OpBox/OpBox_Master/README.md

# OpBox_Master
All Code and Supplementary info for OpBox system

Arduino: Code and libraries to run behavioral task code using Arduino boards

How To: Step-by-step instructions on how to build and implement different components of our system

MATLAB: MATLAB code including scripts for data acquisition and loading recorded data

Processing: Code and libraries for acquiring video and real-time monitoring of Arduino-based behavioral tasks
