OpBox/OpBox_Master/MATLAB/README.md

# OpBoxMAT
MATLAB code for recording physiology data using National Instruments data acquisition devices, plus loading synchronized physiology and behavioral data.
