OpBox/OpBox_Master/HowTo/OpBoxPartsList.xls

Sheet: OpBox
Ordering frequency | SystemPart | Equipment | Vendor | Cost | # | Total | VendorPart | MfgPart | Manufacturer | Web | Notes | Notes | Cost per OpBox | $1409.70 | Possible 1 time expenses | $2499.94
For 10 External Boxes | External Box | Handle | 3D part |  | 10 |  | Custom
For 10 External Boxes | External Box | Contact paper | Amazon
For 10 External Boxes | External Box | Wood: CDX Fir | Jackson Lumber | 65.2400 | 10 | $652.40 |  |  |  |  | 6 precut pieces of CDX Fir: External dimensions for Animal facility rack
For 10 External Boxes | External Box | Hinge Screws: Screw for Wood Phillips, Brass, Number 3, 1/2" Long (Pack of 100) | McMaster | 4.5000 | 1 | $4.50 | 92114A096 |  |  | http://www.mcmaster.com/#92114a096/=ujr445 | #3 Wood Screws For Piano Hinge for boxes
For 10 External Boxes | External Box | Hinge: Type 304 Stainless Steel Piano Hinge with Holes: Unfinished, .025" Thickness, 3/4" Width (1 Ft) | McMaster | 8.6500 | 10 | $86.50 | 97946A100 |  |  | http://www.mcmaster.com/#97946a100/=ujfcyg | For 3/8" Wood box
For 10 External Boxes | External Box | Latch: Velcro | McMaster |  | 1
For 10 External Boxes | External Box | Sound Foam | McMaster |  | 10
For 10 OpBoxes | Behavior: Arduino | CBL USB A-B CON 6' 26/28 AWG | DigiKey | 2.5200 | 10 | $25.20 | Q364-ND | 3021007-06 | Qualtek | http://www.digikey.com/product-detail/en/3021007-06/Q364-ND/1531291 | USB A-to-B cable for Arduino
For 10 OpBoxes | Behavior: Arduino | Power Supply AC/DC WALL MOUNT ADAPTER 12V 36W | DigiKey | 20.2700 | 2 | $40.54 | 237-1443-ND | WSU120-3000 | Triad Magnetics | http://www.digikey.com/product-detail/en/WSU120-3000/237-1443-ND/3094969 | Power supply to be shared among multiple Arduinos | 1
For 10 OpBoxes | Behavior: Arduino | 1x8 DC Power Splitter | M C M Electronics | 6.4900 | 2 | $12.98 | 82-16592 | CT-1S8 | Defender Security | http://www.mcmelectronics.com/product/82-16592 | DC Power splitter to supply each Arduino | 1
For 10 OpBoxes | Behavior: Arduino | ARDUINO A000067 DEV BRD, ATMEGA2560, ARDUINO MEGA 2560 R3 | Newark | 40.4300 | 10 | $404.30 | 45W6205 | A000067 | Arduino | http://www.newark.com/arduino/a000067/dev-brd-atmega2560-arduino-mega/dp/45W6205?ost=A000067 | Arduino Mega 2560
For 10 OpBoxes | Behavior: Arduino | Rosewill RHB-500 - Hub - 10 x Hi-Speed USB - desktop | TigerDirect | 26.9900 | 1 | $26.99 | RWI-102665969 | 11380473 | Rosewill | http://www.tigerdirect.com/applications/SearchTools/item-details.asp?EdpNo=9264070&CatId=11652 | USB Hub
For 10 OpBoxes | Behavior: Fluid | Peristaltic Liquid Pump with Silicone Tubing | M C M Electronics | 23.9900 | 10 | $239.90 | 28-17461 | 1150 | Adafruit | http://www.mcmelectronics.com/product/28-17461 | Peristaltic Pumps, come with 2 pieces of silicone tubing, only need to keep 1 per box | 1
For 10 OpBoxes | Behavior: Fluid | 50 ml amber conical tubes, polypropylene, trays, sterile (Pack of 25) | USA Scientific | 14.5000 | 1 | $14.50 | 5622-7283P |  |  | http://www.usascientific.com/5622-7283p50mlamberconicaltubespolypropylenetrayssterile.aspx | 50ml "Falcon" tube Fluid resevoir
For 10 OpBoxes | Behavior: Fluid | Food and Beverage Nylon Barbed Tube Fitting: Reducing Straight for 1/8" x 1/16" Tube ID (Pack of 10) | McMaster | 2.7600 | 1 | $2.76 | 5116K21 |  |  | http://www.mcmaster.com/#5116k21/=pmsvl0 | Adapter from pump tubing to line tubing
For 10 OpBoxes | Behavior: Fluid | Food and Dairy Clear Tygon PVC Tubing: 1/16" ID, 1/8" OD, 1/32" Wall Thickness | McMaster | 0.2500 | 60 | $15.00 | 6546T33 |  |  | http://www.mcmaster.com/#6546t33/=pmfu94 | Tubing to spout from pump adapter to spout, depends on pump placement (anywhere from 3'-10' depending on the room arrangement)
For 10 OpBoxes | Behavior: Fluid | Masterkleer PVC Tubing (Tygon): 1/8" ID, 1/4" OD | McMaster | 0.1200 | 2 | $0.24 | 5233K52 |  |  | http://www.mcmaster.com/#5233k52/=ocnpnt | Tubing to stabilize narrow tubing within spout, need 2" per spout
For 10 OpBoxes | Behavior: Nosepoke | LED IR 5MM GAA1AS BLUE TH | DigiKey | 0.3150 | 20 | $6.30 | 1080-1080-ND | IR333-A | Everlight Electronics | http://www.digikey.com/product-detail/en/IR333-A/1080-1080-ND/2675571 | Nosepoke IR LED emitters
For 10 OpBoxes | Behavior: Nosepoke | PHOTOTRANSISTOR 5MM BLACK RAD | DigiKey | 0.2700 | 20 | $5.40 | 1080-1158-ND | PT334-6B | Everlight Electronics | http://www.digikey.com/product-detail/en/PT334-6B/1080-1158-ND/2675649 | Nosepoke IR phototransistors
For 10 OpBoxes | Behavior: Nosepoke & Operant Device Connections | FEMALE CRIMP CONTACT SELECTIVE | DigiKey | 0.0840 | 60 | $5.04 | 952-2158-ND | M20-1180042 | Harwin | http://www.digikey.com/product-detail/en/M20-1180042/952-2158-ND/3728124 | M20 Harwin female crimp contacts (22-30 AWG)
For 10 OpBoxes | Behavior: Nosepoke & Operant Device Connections | SIL FEMALE CRIMP HOUSING 2POS | DigiKey | 0.1220 | 30 | $3.66 | 952-2227-ND | M20-1060200 | Harwin | http://www.digikey.com/product-detail/en/M20-1060200/952-2227-ND/3728191 | M20 Harwin female crimp housing
For 10 OpBoxes | Behavior: Nosepoke & Operant Device Connections | HEATSHRNK POLY 1/16" BLK 4' 3:1 | Digi-Key | 0.4240 | 5 | $2.12 | Q2F3X116B-ND | Q2-F3X-1/16-01-QB48IN-25 | Qualtek | http://www.Digi-Key.com/product-detail/en/Q2-F3X-1%2F16-01-QB48IN-25/Q2F3X116B-ND/1210315 (http://www.digikey.com/product-detail/en/Q2-F3X-1%2F16-01-QB48IN-25/Q2F3X116B-ND/1210315) | Heat Shrink tubing:
For 10 OpBoxes | Behavior: Nosepoke & Operant Device Connections | Hook-up Wire 24AWG 7/32 PVC 100ft SPOOL BLACK | Mouser | 22.5100 | 1 | $22.51 | 602-3050-100-02 | 3050 BK005 | Alpha Wire | http://www.mouser.com/ProductDetail/Alpha-Wire/3050-BK005/?qs=sGAEpiMZZMtW9UaYX5J1tM4kpfBO860LCrBFdBMIySg%3d | Hook up wire for operant devices
For 10 OpBoxes | Behavior: Nosepoke & Operant Device Connections | Hook-up Wire 24AWG 7/32 PVC 100ft SPOOL RED | Mouser | 22.5100 | 1 | $22.51 | 602-3050-100-03 | 3050 RD005 | Alpha Wire | http://www.mouser.com/ProductDetail/Alpha-Wire/3050-RD005/ | Hook up wire for operant devices
For 10 OpBoxes | Behavior: Nosepoke: LED | LED SS 5MM 568NM GREEN DIFF | DigiKey | 0.1040 | 10 | $1.04 | 754-1263-ND | WP7113GD | Kingbright | http://www.digikey.com/product-detail/en/WP7113GD/754-1263-ND/1747662 | Nosepoke Green Visible LED
For 10 OpBoxes | Behavior: Nosepoke: Spout | Open Drinking Tube: Straight 2” Length | Ancare | 1.0900 | 10 | $10.90 | OT-99.5 | OT-99.5 | Ancare | http://www.ancare.com/products/watering-equipment/open-drinking-tubes/straight-tubes-open-tip | Nosepoke Spout
For 10 OpBoxes | Behavior: Nosepoke: Spout | Combination Drive Screws for Sheet Metal: #4, 1/2" (pack of 100) | McMaster | 5.1800 | 1 | $5.18 | 92465A142 |  |  | http://www.mcmaster.com/#92465a142/=oz8hit | Drive screws to secure spout
For 10 OpBoxes | Behavior: OpBoxShield | CAP CER 0.068UF 50V 10% RADIAL | DigiKey | 0.2000 | 10 | $2.00 | 445-5302-ND | FK18X7R1H683K | TDK Corporation | http://www.digikey.com/product-detail/en/FK18X7R1H683K/445-5302-ND/2256782 | Capacitor for Audio HPF, 68nF cutoff w/1k Ohm = 2.3405 kHz
For 10 OpBoxes | Behavior: OpBoxShield | CAP CER 6800PF 50V 10% RADIAL | DigiKey | 0.2040 | 10 | $2.04 | 445-5296-ND | FK18X7R1H682K | TDK Corporation | http://www.digikey.com/product-detail/en/FK18X7R1H682K/445-5296-ND/2256776 | Capacitor for Audio LPF, 6.8nF cutoff w/1k Ohm = 23.405 kHz
For 10 OpBoxes | Behavior: OpBoxShield | CAP ALUM 10UF 25V 10% RADIAL | DigiKey | 0.2870 | 20 | $5.74 | 493-13398-ND | UKL1E100KDDANA | Nichicon | http://www.digikey.com/product-detail/en/UKL1E100KDDANA/493-13398-ND/2598410 | Capacitor for Power at Battery outputs
For 10 OpBoxes | Behavior: OpBoxShield | IDC BOX HEADER .100" 20POS | DigiKey | 0.6300 | 10 | $6.30 | 1175-1612-ND | 3020-20-0100-00 | CNC Tech | http://www.digikey.com/product-detail/en/3020-20-0100-00/1175-1612-ND/3441738 | Board connector for device ribbon cable
For 10 OpBoxes | Behavior: OpBoxShield | PHOTOCOUPLER PHOTORELAY 4-DIP | DigiKey | 1.0130 | 10 | $10.13 | TLP222AF-ND | TLP222A(F) | Toshiba | http://www.digikey.com/product-detail/en/TLP222A(F)/TLP222AF-ND/871243 | Solid state relay (<= 2ms on/off)
For 10 OpBoxes | Behavior: OpBoxShield | RES 100 OHM 1W 5% AXIAL | DigiKey | 0.0940 | 40 | $3.76 | 100WCT-ND | FMP100JR-52-100R | Yageo | http://www.digikey.com/product-detail/en/FMP100JR-52-100R/100WCT-ND/2058886 | Small resistors for OperantShield
For 10 OpBoxes | Behavior: OpBoxShield | RES 120 OHM 1/2W 5% AXIAL | DigiKey | 0.1320 | 20 | $2.64 | 120DVCT-ND | FRM50SJR-52-120R | Yageo | http://www.digikey.com/product-detail/en/FRM50SJR-52-120R/120DVCT-ND/2813214 | Small 1/2 Watt resistors for OperantShield
For 10 OpBoxes | Behavior: OpBoxShield | RES 1K OHM 1W 5% AXIAL | DigiKey | 0.0940 | 40 | $3.76 | 1KWCT-ND | FMP100JR-52-1K | Yageo | http://www.digikey.com/product-detail/en/FMP100JR-52-1K/1KWCT-ND/2058902 | Small 1 Watt. Thin resistors for tight OperantShield spacing
For 10 OpBoxes | Behavior: OpBoxShield | RES 2K OHM 1/4W 1% AXIAL | DigiKey | 0.0840 | 10 | $0.84 | 2.00KXBK-ND | MFR-25FBF52-2K | Yageo | http://www.digikey.com/product-detail/en/MFR-25FBF52-2K/2.00KXBK-ND/13070 | Small resistors for relay on OperantShield
For 10 OpBoxes | Behavior: OpBoxShield | RES 330 OHM 1W 5% AXIAL | DigiKey | 0.0940 | 30 | $2.82 | 330WCT-ND | FMP100JR-52-330R | Yageo | http://www.digikey.com/product-detail/en/FMP100JR-52-330R/330WCT-ND/2058918 | Small 1 Watt resistors for OperantShield
For 10 OpBoxes | Behavior: OpBoxShield | CONN BNC JACK R/A 50 OHM PCB | DigiKey | 1.8380 | 10 | $18.38 | A97553-ND | 1-1337543-0 | TE Connectivity | http://www.digikey.com/product-detail/en/1-1337543-0/A97553-ND/1755940 | BNC output jack for digital triggers
For 10 OpBoxes | Behavior: OpBoxShield | IC MOTOR DRIVER PAR 16-DIP | DigiKey | 3.7500 | 10 | $37.50 | 296-9518-5-ND | L293DNE | Texas Instruments | http://www.digikey.com/product-detail/en/L293DNE/296-9518-5-ND/379724 | Pump motor driver (reversible for 2 pumps)
For 10 OpBoxes | Behavior: OpBoxShield | CONN HEADER VERT .100 2POS 30AU | Digi-Key | 0.5650 | 100 | $56.50 | A28473-ND | 103908-1 | TE Connectivity | http://www.digikey.com/product-detail/en/103908-1/A28473-ND/298654 | AmpModu 2 pin male housing for board, with Latch. Press-Fit, Solder. For connections of each 2 conductor cable, extra stability
For 10 OpBoxes | Behavior: OpBoxShield | CONN HEADER VERT 2POS .100 TIN | Digi-Key | 0.0804 | 100 | $8.04 | A1921-ND | 640456-2 | TE Connectivity | http://www.digikey.com/product-detail/en/640456-2/A1921-ND/109003 | Alternative Friction lock rather than latch lock for 2 conductor cables. Match with MTA100 connectors, allow for tighter spacing than latch lock
For 10 OpBoxes | Behavior: OpBoxShield | CONN TERMINAL BLOCK 2POS 3.5MM | Digi-Key | 0.6550 | 10 | $6.55 | WM7877-ND | 0393570002 | Molex Inc | http://www.digikey.com/product-detail/en/0393570002/WM7877-ND/946543 | Terminal Screw Block: For operant shield multiplexed digital->analog output | ?
For 10 OpBoxes | Behavior: OpBoxShield | CONN TERMINAL BLOCK 6POS 5.08MM | Digi-Key | 2.0420 | 10 | $20.42 | WM7857-ND | 0395443006 | Molex Inc | http://www.digikey.com/product-search/en?x=0&y=0&lang=en&site=us&keywords=WM7857-ND | Terminal Screw Block: 6 position for 5 signal & 1 Ground digital outputs | ?
For 10 OpBoxes | Behavior: OpBoxShield | RES NET MULT OHM 16 RES 10SIP | Digi-Key | 0.9300 | 10 | $9.30 | 4310R-R2R-103LF-ND | 4310R-R2R-103LF |  | http://www.digikey.com/product-detail/en/4310R-R2R-103LF/4310R-R2R-103LF-ND/3741102 | R2R Resistor Ladder Network for DAC Arduino->NI USB | ?
For 10 OpBoxes | Behavior: OpBoxShield | Male pins HEADER, 2.54MM, THT VERT, 36POS | Newark | 2.8100 | 10 | $28.10 | 02R1933 | TSW-118-10-F-D | Samtec Inc | http://www.newark.com/samtec/tsw-118-10-f-d/header-2-54mm-tht-vert-36pos/dp/02R1933 | Male pins for PosTrack connections. Could also do 10 pin stackable headers side by side with male pin interface | ?
For 10 OpBoxes | Behavior: OpBoxShield | Arduino 8-Pin Stackable Headers (10) | RobotShop | 2.9900 | 4 | $11.96 | RB-Dfr-269 |  |  | http://www.robotshop.com/en/arduino-8-pin-stackable-headers-10.html | Arduino headers, 10 per pack, need 4 per board (if not using analog inputs, and if using male pins at PosTrack side--otherwise would need 10) | ?
For 10 OpBoxes | Behavior: OpBoxShield | OperantShield Printed Circuit Board | Sunstone | 27.7000 | 10 | $277.00 | Custom | OperantShield | DeliriumLab.org | http://deliriumlab.org/ | Custom PCB for Operant Shield
For 10 OpBoxes | Behavior: Operant Device Connections | CABLE 40 COND 50FT FLAT GRAY | DigiKey | 50.5000 | 1 | $50.50 | MC40G-50-ND | 3365/40 300SF | 3M | http://www.digikey.com/product-detail/en/3365%2F40%20300SF/MC40G-50-ND/145467 | Ribbon cable for operant devices: ten 10' cables (1/2 of full width). Approximately twice as much for multicolor | 1
For 10 OpBoxes | Behavior: Operant Device Connections | CONN SOCKET IDC 20POS W/KEY GOLD | DigiKey | 0.4130 | 20 | $8.26 | ED10503-ND | 101-206 | On Shore Technology Inc | http://www.digikey.com/product-detail/en/101-206/ED10503-ND/2794215 | IDC press connector for Ribbon cable to devices, does not get soldered onto shield itself | 1
For 10 OpBoxes | Behavior: Operant Device Connections | Symmetric Male Pins: CONN HEADER .100" SNGL STR 40POS | DigiKey | 0.6400 | 5 | $3.20 | S1022EC-40-ND | PREC040SABN-RC | Sullins | http://www.digikey.com/product-detail/en/PREC040SABN-RC/S1022EC-40-ND/2775014 | Male 5.84mm pins. 20 pins per box = 200pins. For Device cable
For 10 OpBoxes | Behavior: PosTrack | CBL RIBN 34COND 0.050 GRAY 100' | DigiKey | 77.2700 | 1 | $77.27 | MC34G-100-ND | 3365/34 300SF | 3M | http://www.digikey.com/product-detail/en/3365%2F40%20300SF/MC40G-50-ND/145467 | Ribbon cable for PosTrack: ten 10' cables (full width). Approximately twice as much for multicolor
For 10 OpBoxes | Behavior: PosTrack | CONN SOCKET IDC 34POS W/KEY GOLD | DigiKey | 0.5610 | 10 | $5.61 | HKC34H-ND | AWP34-7240-T-R |  | http://www.digikey.com/product-detail/en/AWP34-7240-T-R/HKC34H-ND/924351 | Connector to Arduino for Ribbon cable to photodarlingtons
For 10 OpBoxes | Behavior: PosTrack | IR EMITTER 850NM HIGH SPEED DIP | DigiKey | 0.8438 | 210 | $177.20 | VSLY5850-ND | VSLY5850 | Vishay | http://www.digikey.com/product-detail/en/VSLY5850/VSLY5850-ND/2615286 | Narrow IR LED emitters for PosTrack, need 21/box for 9"x12" box
For 10 OpBoxes | Behavior: PosTrack | MTA 100: Headers & Wire Housings FEED THRU W/O TAB 2P green tin 28 AWG | DigiKey | 0.1727 | 200 | $34.54 | A30814-ND | 3-640623-2 | TE Connectivity | http://www.digikey.com/product-search/en?KeyWords=3-640623-2&WT.z_header=search_go | For IR photodarlington connections for PosTrack (need 22 per box: 21 photodarlingtons + ground connection)
For 10 OpBoxes | Behavior: PosTrack | PHOTODARLINGTON SILICON NPN T-1 (OP535B) | DigiKey | 0.7100 | 210 | $149.10 | 365-1604-ND | OP535B | TT Electronics/Optek | http://www.digikey.com/product-detail/en/OP535B/365-1604-ND/1636678 | Sensitive IR photodarlingtons for PosTrack, need 21/box for 9"x12" box
For 10 OpBoxes | Behavior: PosTrack | MTA-100 CONN STRAIN RELIEF COVER 2POS | Digi-Key | 0.2708 | 30 | $8.12 | A19230-ND | 643075-2 | TE Connectivity | http://www.digikey.com/product-detail/en/643075-2/A19230-ND/258866 | Optional Strain relievers: Terminator MTA 100 connectors
For 10 OpBoxes | Behavior: PosTrack | MTA-100 CONN STRAIN RELIEF COVER 2POS | Digi-Key | 0.2533 | 200 | $50.66 | A19270-ND | 643077-2 | TE Connectivity | http://www.digikey.com/product-detail/en/643077-2/A19270-ND/258891 | Optional Strain relievers: Pass through MTA 100 connectors
For 10 OpBoxes | Behavior: PosTrack | Hook-up Wire 28AWG 7/36 PVC 100ft SPOOL BLACK | Mouser | 19.5800 | 1 | $19.58 | 602-3048-100-02 | 3048 BK005 | Alpha Wire | http://www.mouser.com/ProductDetail/Alpha-Wire/3048-BK005/?qs=sGAEpiMZZMtW9UaYX5J1tGDFHZdPhOTYWWT7MJgMuTU%3d | Ground wire for Position Tracker
For 10 OpBoxes | Behavior: PosTrack + Pump | MTA 100: Headers & Wire Housings CLOSED W/O TABS 2P white tin 24 AWG | Mouser | 0.1200 | 30 | $3.60 | 571-640441-2 | 640441-2 | TE Connectivity | http://www.mouser.com/ProductDetail/TE-Connectivity/640441-2/ | For IR LED emitter connections for PosTrack, 3 per 21 LEDs (can run 7 on 12 V)
For 10 OpBoxes | Behavior: Speaker | SPEAKER 8 OHM .1W 40MM ROUND | DigiKey | 3.6240 | 10 | $36.24 | GF0401M-ND | GF0401M | CUI Inc | http://www.digikey.com/product-detail/en/GF0401M/GF0401M-ND/304449 | Relatively flat frequency response speaker | 1
For 10 OpBoxes | Behavior: Webcam | Micro Innovations ChatCam | P C Connection | 11.0900 | 10 | $110.90 | 12556153 | 4310100 | Digital Innovations | http://www.pcconnection.com/product/micro-innovations-chatcam/4310100/12556153?cac=Result | WebCam modifiable for Infrared
For 10 OpBoxes | Physiology: Acquisition from Amplifier | 10' BNC M-M Patch Cable RG58 Coax 50 ohm | M C M Electronics | 3.7700 | 8 | $30.16 | 24-15626 | 24-15626 | Pro Signal | http://www.mcmelectronics.com/product/24-15626 | Connection from Physiology Amplifier to Acquisition
For 10 OpBoxes | Physiology: Acquisition from Amplifier | NI CB-68LPR Unshielded 68-pin I/O Connector Block | National Instruments | 114.0000 | 2 | $228.00 | 777145-02 |  |  | http://sine.ni.com/nips/cds/view/p/lang/en/nid/1186 | Breakout board for NI PCI cards
For 10 OpBoxes | Physiology: Acquisition from Amplifier | NI PCI-6225 16-Bit, 250 kS/s, 80 Analog Inputs Multifunction DAQ | National Instruments | 1348.0000 | 1 | $1348.00 | 779295-01 |  |  | http://sine.ni.com/nips/cds/view/p/lang/en/nid/201605 | Acquisition Card: 40 Differential Analog Inputs, 8 Clocked Digital Inputs
For 10 OpBoxes | Physiology: Acquisition from Amplifier | NI PCIe-6323 X Series Data Acquisition | National Instruments | 869.0000 | 0 | $0.00 | 781045-01 |  |  | http://sine.ni.com/nips/cds/view/p/lang/en/nid/207406 | Acquisition Card: 16 Differential Analog Inputs, 32 Clocked Digital Inputs. If subsitute or add this to PCI-6225, will have to substitute shielded cables since analog & digital are mixed on both boxes and double the overall number of NI parts (16 channels = 5 subjects)
For 10 OpBoxes | Physiology: Acquisition from Amplifier | NI USB-6009 14-Bit, 48 kS/s Low-Cost Multifunction DAQ | National Instruments | 299.0000 | 1 | $299.00 | 779026-01 |  |  | http://sine.ni.com/nips/cds/view/p/lang/en/nid/201987 | Acquisition Device: USB: 4 Differential Analog Inputs, but no clocked Digital Inputs. If use this do not need breakout boards and cables, but will need 10, 1 for each subject. The behavioral data will then need to be multiplexed into the remaining analog channel
For 10 OpBoxes | Physiology: Acquisition from Amplifier | NI SHC68-68 Cable (2m) | National Instruments | 103.0000 | 1 | $103.00 | 191945-02 |  |  | http://sine.ni.com/nips/cds/view/p/lang/en/nid/201629 | No shielding for analog only portion of PCI-6225, Recommended by NI
For 10 OpBoxes | Physiology: Acquisition from Amplifier | NI SHC68-68-EPM Cable (2m) | National Instruments | 140.0000 | 1 | $140.00 | 192061-02 |  |  | http://sine.ni.com/nips/cds/view/p/lang/en/nid/201628 | Shielded cable for shared analog & digital portion
For 10 OpBoxes | Physiology: Acquisition from Arduino | 3' BNC M-M Patch Cable RG58 Coax 50 ohm | M C M Electronics | 2.3300 | 10 | $23.30 | 24-15623 | 24-15623 | Pro Signal | http://www.mcmelectronics.com/product/PRO-SIGNAL-24-15623-/24-15623 | Connection from Arduino OperantShield (BNC) to Physiology Acquisition
For 10 OpBoxes | Physiology: Acquisition from Arduino | Multi-Conductor Cables 24AWG 4C SHIELD 100ft SPOOL CHROME | Mouser | 61.2300 | 1 | $61.23 | 566-9534-100 | 9534 060100 | Belden Wire & Cable | http://www.mouser.com/ProductDetail/Belden-Wire-Cable/9534-060100/ | Connection from Arduino OperantShield (Screw Terminal) to Physiology Acquisition
For 10 OpBoxes | Physiology: Amplifier 3Ch | BUMPER CYLIN 0.312" DIA BLK | Digi-Key | 0.0762 | 144 | $10.97 | SJ5746-0-ND | SJ61A1 | 3M | http://www.digikey.com/product-detail/en/SJ61A1/SJ5746-0-ND/1768456 | Rubber bumper feet for amp
For 10 OpBoxes | Physiology: Amplifier 3Ch | CAP CER 0.047UF 50V 5% RADIAL | Digi-Key | 0.4670 | 30 | $14.01 | 445-8327-ND | FK16C0G1H473J | TDK Corporation | http://www.digikey.com/product-detail/en/FK16C0G1H473J/445-8327-ND/2815257 | For 2 pole Active Low pass filter, Gain = 1, F = 200 Hz, Q~0.71
For 10 OpBoxes | Physiology: Amplifier 3Ch | CAP CER 0.1UF 50V 5% RADIAL | Digi-Key | 0.4000 | 210 | $84.00 | 445-8325-ND | FK16C0G1H104J | TDK Corporation | http://www.digikey.com/product-detail/en/FK16C0G1H104J/445-8325-ND/2815255 | For power inputs & 2 pole Active Low pass filter, Gain = 1, F = 200 Hz, Q~0.71. COG 5%
For 10 OpBoxes | Physiology: Amplifier 3Ch | CAP FILM 1UF 63VDC RADIAL | Digi-Key | 0.4550 | 60 | $27.30 | 495-1119-ND | B32529C105J | EPCOS Inc | http://www.digikey.com/product-detail/en/B32529C105J/495-1119-ND/592697 | For 2 pole Active High pass filter, Gain = 1, F = 0.28 Hz, Q~0.71. Film Cap
For 10 OpBoxes | Physiology: Amplifier 3Ch | CONN BNC JACK R/A 50 OHM PCB | Digi-Key | 1.7252 | 30 | $51.76 | A97553-ND | 1-1337543-0 | TE Connectivity | http://www.digikey.com/product-detail/en/1-1337543-0/A97553-ND/1755940 | BNC output jacks
For 10 OpBoxes | Physiology: Amplifier 3Ch | CONN HEADER VERT .100 2POS 30AU | Digi-Key | 0.7300 | 20 | $14.60 | A28473-ND | 103908-1 | TE Connectivity | http://www.digikey.com/product-detail/en/103908-1/A28473-ND/298654 | AmpModu 2 pin male pins w/housing for amp power input, with Latch. Press-Fit, Solder
For 10 OpBoxes | Physiology: Amplifier 3Ch | CONN TERM BLOCK 6POS 5.08MM PCB | Digi-Key | 2.6290 | 10 | $26.29 | 277-1251-ND | 1729160 | Phoenix Contact | http://www.digikey.com/product-detail/en/1729160/277-1251-ND/260619 | Screw Terminal for 6 Ch 0.200" spacing for amp Ch3
For 10 OpBoxes | Physiology: Amplifier 3Ch | IC OPAMP GP 2.2MHZ 8DIP | Digi-Key | 2.1500 | 60 | $129.00 | 296-7365-5-ND | TLC277IP | Texas Instruments | http://www.digikey.com/product-detail/en/TLC277IP/296-7365-5-ND/374913 | OpAmp (used in OpenEEG too)
For 10 OpBoxes | Physiology: Amplifier 3Ch | IC SOCKET STRAIGHT 8POS TIN | Digi-Key | 0.1288 | 90 | $11.59 | AE9986-ND | A08-LC-TT-R | Assman WSW Components | http://www.digikey.com/product-detail/en/A08-LC-TT-R/AE9986-ND/821740 | Chipsets for Amplifiers Integrated Circuits
For 10 OpBoxes | Physiology: Amplifier 3Ch | INA114BP IC OPAMP INSTR 1MHZ 8DIP | Digi-Key | 12.1044 | 30 | $363.13 | INA114BP-ND | INA114BP | Texas Instruments | http://www.digikey.com/product-search/en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 | Instrument Amp (used in OpenEEG too)
For 10 OpBoxes | Physiology: Amplifier 3Ch | LED 3MM HI EFF RED RED DIFF | Digi-Key | 0.3220 | 20 | $6.44 | 160-1957-ND | LTL-4221NLC | Lite-On Inc | http://www.digikey.com/product-detail/en/LTL-4221NLC/160-1957-ND/3198526 | LED Indicators for Amp Power
For 10 OpBoxes | Physiology: Amplifier 3Ch | RES 100K OHM 1/4W 0.1% AXIAL | Digi-Key | 0.1497 | 60 | $8.98 | 100KADCT-ND | MFP-25BRD52-100K | Yageo | http://www.digikey.com/product-detail/en/MFP-25BRD52-100K/100KADCT-ND/2059112 | For bias currents at inputs
For 10 OpBoxes | Physiology: Amplifier 3Ch | RES 100K OHM 1/4W 1% AXIAL | Digi-Key | 0.0580 | 60 | $3.48 | 100KXBK-ND | MFR-25FBF52-100K | Yageo | http://www.digikey.com/product-detail/en/MFR-25FBF52-100K/100KXBK-ND/13473 | For 10x Gain across Op Amp
For 10 OpBoxes | Physiology: Amplifier 3Ch | RES 10K OHM 1/4W 1% AXIAL | Digi-Key | 0.0580 | 60 | $3.48 | 10.0KXBK-ND | MFR-25FBF52-10K | Yageo | http://www.digikey.com/product-detail/en/MFR-25FBF52-10K/10.0KXBK-ND/13219 | For 10x Gain across Op Amp
For 10 OpBoxes | Physiology: Amplifier 3Ch | RES 15K OHM 1/4W 1% AXIAL | Digi-Key | 0.0580 | 30 | $1.74 | 15.0KXBK-ND | MFR-25FBF52-15K | Yageo | http://www.digikey.com/product-detail/en/MFR-25FBF52-15K/15.0KXBK-ND/13252 | For 2 pole Active Low pass filter, Gain = 1, F = 200 Hz, Q~0.71
For 10 OpBoxes | Physiology: Amplifier 3Ch | RES 1M OHM 1/4W 1% AXIAL | Digi-Key | 0.0580 | 30 | $1.74 | 1.00MXBK-ND | MFR-25FBF52-1M | Yageo | http://www.digikey.com/product-detail/en/MFR-25FBF52-1M/1.00MXBK-ND/13714 | For 2 pole Active High pass filter, Gain = 1, F = 0.28 Hz, Q~0.71
For 10 OpBoxes | Physiology: Amplifier 3Ch | RES 499K OHM 1/4W 1% AXIAL | Digi-Key | 0.0580 | 30 | $1.74 | 499KXBK-ND | MFR-25FBF52-499K | Yageo | http://www.digikey.com/product-detail/en/MFR-25FBF52-499K/499KXBK-ND/13656 | For 2 pole Active High pass filter, Gain = 1, F = 0.28 Hz, Q~0.71
For 10 OpBoxes | Physiology: Amplifier 3Ch | RES 5.62K OHM 1/4W 1% AXIAL | Digi-Key | 0.0580 | 50 | $2.90 | 5.62KXBK-ND | MFR-25FBF52-5K62 | Yageo | http://www.digikey.com/product-detail/en/MFR-25FBF52-5K62/5.62KXBK-ND/13171 | Across Instrument Amplifier for Gain of 10x (1+50/5.62) & For LED Indicators
For 10 OpBoxes | Physiology: Amplifier 3Ch | RES 9.09K OHM 1/4W 1% AXIAL | Digi-Key | 0.0580 | 30 | $1.74 | 9.09KXBK-ND | MFR-25FBF52-9K09 | Yageo | http://www.digikey.com/product-detail/en/MFR-25FBF52-9K09/9.09KXBK-ND/13211 | For 2 pole Active Low pass filter, Gain = 1, F = 200 Hz, Q~0.71
For 10 OpBoxes | Physiology: Amplifier 3Ch | Switch PCB Dpdt Horiz | M C M Electronics | 2.0200 | 10 | $20.20 | 26-4370 | 98K4951 | Multicomp | http://www.mcmelectronics.com/product/MULTICOMP-98K4951-/26-4370 | Switch for Amplifier power
For 10 OpBoxes | Physiology: Amplifier 3Ch | DeliriumLab Amp Printed Circuit Board | Sunstone | 33.8000 | 10 | $338.00 | Custom | OperantShield | DeliriumLab.org | http://deliriumlab.org/ | Custom PCB for Electrophysiology Amplifier
For 10 OpBoxes | Physiology: Amplifier 4Ch | BUMPER CYLIN 0.312" DIA BLK | Digi-Key | 0.0762 | 144 | $10.97 | SJ5746-0-ND | SJ61A1 | 3M | http://www.digikey.com/product-detail/en/SJ61A1/SJ5746-0-ND/1768456 | Rubber bumper feet for amp
For 10 OpBoxes | Physiology: Amplifier 4Ch | CAP CER 0.047UF 50V 5% RADIAL | Digi-Key | 0.4670 | 40 | $18.68 | 445-8327-ND | FK16C0G1H473J | TDK Corporation | http://www.digikey.com/product-detail/en/FK16C0G1H473J/445-8327-ND/2815257 | For 2 pole Active Low pass filter, Gain = 1, F = 200 Hz, Q~0.71
For 10 OpBoxes | Physiology: Amplifier 4Ch | CAP CER 0.1UF 50V 5% RADIAL | Digi-Key | 0.3667 | 280 | $102.67 | 445-8325-ND | FK16C0G1H104J | TDK Corporation | http://www.digikey.com/product-detail/en/FK16C0G1H104J/445-8325-ND/2815255 | For power inputs & 2 pole Active Low pass filter, Gain = 1, F = 200 Hz, Q~0.71. COG 5%
For 10 OpBoxes | Physiology: Amplifier 4Ch | CAP FILM 1UF 63VDC RADIAL | Digi-Key | 0.4550 | 80 | $36.40 | 495-1119-ND | B32529C105J | EPCOS Inc | http://www.digikey.com/product-detail/en/B32529C105J/495-1119-ND/592697 | For 2 pole Active High pass filter, Gain = 1, F = 0.28 Hz, Q~0.71. Film Cap
For 10 OpBoxes | Physiology: Amplifier 4Ch | CONN TERM BLOCK 8POS 5.08MM PCB | Digi-Key | 3.5090 | 10 | $35.09 | 277-1253-ND | 1729186 | Phoenix Contact | http://www.digikey.com/product-search/en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 | Screw Terminal for Ch 0.200" spacing for amp Ch4 w/Screw Terminal Output
For 10 OpBoxes | Physiology: Amplifier 4Ch | CONN MOD JACK R/A 8P8C SHIELDED | Digi-Key | 1.7010 | 10 | $17.01 | 380-1047-ND | SS-7188S-A-NF | Stewart Connector | http://www.digikey.com/product-detail/en/SS-7188S-A-NF/380-1047-ND/388309 | Ethernet Output for Amp 4Ch
For 10 OpBoxes | Physiology: Amplifier 4Ch | CONN MOD JACK 8P8C | Digi-Key | 4.9950 | 10 | $49.95 | 380-1100-ND | SS-82000-002 |  | http://www.digikey.com/product-detail/en/SS-82000-002/380-1100-ND/459026 | Ethernet Input for NI system
For 10 OpBoxes | Physiology: Amplifier 4Ch | CONN HEADER VERT .100 2POS 30AU | Digi-Key | 0.7300 | 20 | $14.60 | A28473-ND | 103908-1 | TE Connectivity | http://www.digikey.com/product-detail/en/103908-1/A28473-ND/298654 | AmpModu 2 pin male pins w/housing for amp power input, with Latch. Press-Fit, Solder
For 10 OpBoxes | Physiology: Amplifier 4Ch | CONN TERM BLOCK 6POS 5.08MM PCB | Digi-Key | 2.6290 | 10 | $26.29 | 277-1251-ND | 1729160 | Phoenix Contact | http://www.digikey.com/product-detail/en/1729160/277-1251-ND/260619 | Screw Terminal for 6 Ch 0.200" spacing for amp input
For 10 OpBoxes | Physiology: Amplifier 4Ch | IC OPAMP GP 2.2MHZ 8DIP | Digi-Key | 2.1500 | 80 | $172.00 | 296-7365-5-ND | TLC277IP | Texas Instruments | http://www.digikey.com/product-detail/en/TLC277IP/296-7365-5-ND/374913 | OpAmp (used in OpenEEG too)
For 10 OpBoxes | Physiology: Amplifier 4Ch | IC SOCKET STRAIGHT 8POS TIN | Digi-Key | 0.1288 | 120 | $15.46 | AE9986-ND | A08-LC-TT-R | Assman WSW Components | http://www.digikey.com/product-detail/en/A08-LC-TT-R/AE9986-ND/821740 | Chipsets for Amplifiers Integrated Circuits
For 10 OpBoxes | Physiology: Amplifier 4Ch | INA114BP IC OPAMP INSTR 1MHZ 8DIP | Digi-Key | 12.1044 | 40 | $484.18 | INA114BP-ND | INA114BP | Texas Instruments | http://www.digikey.com/product-search/en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 | Instrument Amp (used in OpenEEG too)
For 10 OpBoxes | Physiology: Amplifier 4Ch | LED 3MM HI EFF RED RED DIFF | Digi-Key | 0.3220 | 20 | $6.44 | 160-1957-ND | LTL-4221NLC | Lite-On Inc | http://www.digikey.com/product-detail/en/LTL-4221NLC/160-1957-ND/3198526 | LED Indicators for Amp Power
For 10 OpBoxes | Physiology: Amplifier 4Ch | RES 100K OHM 1/4W 0.1% AXIAL | Digi-Key | 0.1497 | 80 | $11.98 | 100KADCT-ND | MFP-25BRD52-100K | Yageo | http://www.digikey.com/product-detail/en/MFP-25BRD52-100K/100KADCT-ND/2059112 | For bias currents at inputs
For 10 OpBoxes | Physiology: Amplifier 4Ch | RES 100K OHM 1/4W 1% AXIAL | Digi-Key | 0.0580 | 80 | $4.64 | 100KXBK-ND | MFR-25FBF52-100K | Yageo | http://www.digikey.com/product-detail/en/MFR-25FBF52-100K/100KXBK-ND/13473 | For 10x Gain across Op Amp
For 10 OpBoxes | Physiology: Amplifier 4Ch | RES 10K OHM 1/4W 1% AXIAL | Digi-Key | 0.0580 | 80 | $4.64 | 10.0KXBK-ND | MFR-25FBF52-10K | Yageo | http://www.digikey.com/product-detail/en/MFR-25FBF52-10K/10.0KXBK-ND/13219 | For 10x Gain across Op Amp
For 10 OpBoxes | Physiology: Amplifier 4Ch | RES 15K OHM 1/4W 1% AXIAL | Digi-Key | 0.0580 | 40 | $2.32 | 15.0KXBK-ND | MFR-25FBF52-15K | Yageo | http://www.digikey.com/product-detail/en/MFR-25FBF52-15K/15.0KXBK-ND/13252 | For 2 pole Active Low pass filter, Gain = 1, F = 200 Hz, Q~0.71
For 10 OpBoxes | Physiology: Amplifier 4Ch | RES 1M OHM 1/4W 1% AXIAL | Digi-Key | 0.0580 | 40 | $2.32 | 1.00MXBK-ND | MFR-25FBF52-1M | Yageo | http://www.digikey.com/product-detail/en/MFR-25FBF52-1M/1.00MXBK-ND/13714 | For 2 pole Active High pass filter, Gain = 1, F = 0.28 Hz, Q~0.71
For 10 OpBoxes | Physiology: Amplifier 4Ch | RES 499K OHM 1/4W 1% AXIAL | Digi-Key | 0.0580 | 40 | $2.32 | 499KXBK-ND | MFR-25FBF52-499K | Yageo | http://www.digikey.com/product-detail/en/MFR-25FBF52-499K/499KXBK-ND/13656 | For 2 pole Active High pass filter, Gain = 1, F = 0.28 Hz, Q~0.71
For 10 OpBoxes | Physiology: Amplifier 4Ch | RES 5.62K OHM 1/4W 1% AXIAL | Digi-Key | 0.0580 | 60 | $3.48 | 5.62KXBK-ND | MFR-25FBF52-5K62 | Yageo | http://www.digikey.com/product-detail/en/MFR-25FBF52-5K62/5.62KXBK-ND/13171 | Across Instrument Amplifier for Gain of 10x (1+50/5.62) & For LED Indicators
For 10 OpBoxes | Physiology: Amplifier 4Ch | RES 9.09K OHM 1/4W 1% AXIAL | Digi-Key | 0.0580 | 40 | $2.32 | 9.09KXBK-ND | MFR-25FBF52-9K09 | Yageo | http://www.digikey.com/product-detail/en/MFR-25FBF52-9K09/9.09KXBK-ND/13211 | For 2 pole Active Low pass filter, Gain = 1, F = 200 Hz, Q~0.71
For 10 OpBoxes | Physiology: Amplifier 4Ch | Switch PCB Dpdt Horiz | M C M Electronics | 2.0200 | 10 | $20.20 | 26-4370 | 98K4951 | Multicomp | http://www.mcmelectronics.com/product/MULTICOMP-98K4951-/26-4370 | Switch for Amplifier power
For 10 OpBoxes | Physiology: Amplifier 4Ch | DeliriumLab Amp Printed Circuit Board | Sunstone | 33.8000 | 10 | $338.00 | Custom | OperantShield | DeliriumLab.org | http://deliriumlab.org/ | Custom PCB for Electrophysiology Amplifier
For 10 OpBoxes | Physiology: Battery Power | CONN RECPT 2POS .1" POL UNLOAD | Digi-Key | 0.3570 | 20 | $7.14 | A28393-ND | 104257-1 | TE Connectivity | http://www.digikey.com/product-detail/en/104257-1/A28393-ND/289301 | AmpModu 2 pin housing for female sockets for battery power output, with Latch
For 10 OpBoxes | Physiology: Battery Power | CONN SOCKET 22-26AWG 30AU CRIMP | Digi-Key | 0.1776 | 40 | $7.10 | A32513-ND | 1-104480-6 | TE Connectivity | http://www.digikey.com/product-detail/en/1-104480-6/A32513-ND/1014904 | AmpModu Socket contacts for 2 pin housing at 0.100 spacing for battery power connectors: 22-26 AWG
For 10 OpBoxes | Physiology: Battery Power | Battery Holder 2xaa Snap 150mm Lead | M C M Electronics | 0.4100 | 20 | $8.20 | 28-12561 | 23VB21A | Pro Signal | http://www.mcmelectronics.com/product/PRO-POWER-23VB21A-/28-12561 | Battery Holder (2 AA)
For 10 OpBoxes | Physiology: Battery Power | MEDC BATTERIES ALK AA 1.5 VOLT BX/24EA | Owens & Minor | 3.8100 | 2 | $7.62 | 1314BATTAA | BATTAA | OM MAIN STREET | http://www.owens-minor.com/Pages/default.aspx | Batteries: AA Alkaline
For 10 OpBoxes | Physiology: Cable | CONN RCPT 3MM 6POS DL MATE-N-L | Digi-Key | 0.4900 | 10 | $4.90 | A30295-ND | 794617-6 | TE Connectivity | http://www.digikey.com/product-detail/en/794617-6/A30295-ND/685018 | Crimp connectors for male/female pin combo for commutator: Mico MATE-N-LOCK, AMP. Female socket holder
For 10 OpBoxes | Physiology: Cable | CONN SOCKET 30-26AWG GOLD CRIMP | Digi-Key | 0.1186 | 60 | $7.12 | 1-794611-1-ND | 1-794611-1 | TE Connectivity | http://www.digikey.com/product-detail/en/1-794611-1/1-794611-1-ND/2259415 | Crimp connectors for male/female pin combo for commutator: Mico MATE-N-LOCK, AMP. Female socket contacts. 3mm TE connectors
For 10 OpBoxes | Physiology: Cable | Cables: 6 Channel Open ended: Spring: 100cm long | Plastics1 | 32.7000 | 10 | $327.00 | 363-000 W/ SPRING |  |  | http://www.plastics1.com/Gallery-PRC.php?CMD=VIEW | Cables: 6 channels with Spring shielding
For 10 OpBoxes | Physiology: Commutator | CONN PIN CONT 26-30AWG GOLD | Digi-Key | 0.0948 | 60 | $5.69 | 1-794613-1-ND | 1-794613-1 | TE Connectivity | http://www.digikey.com/product-detail/en/1-794613-1/1-794613-1-ND/2259374 | Commutator male pins: Mico MATE-N-LOCK, AMP. Male pin contacts. 3mm TE connectors
For 10 OpBoxes | Physiology: Commutator | CONN PLUG 3MM 6POS DL MATE-N-LOK | Digi-Key | 0.6090 | 10 | $6.09 | A30271-ND | 794616-6 | TE Connectivity | http://www.digikey.com/product-detail/en/794616-6/A30271-ND/684994 | Commutator plug: Mico MATE-N-LOCK, AMP. Male pin holder. 3mm TE connectors
For 10 OpBoxes | Physiology: Commutator | Slip Ringer with Flange | M C M Electronics | 15.0300 | 10 | $150.30 | 28-17456 | 736 | Adafruit Industries | http://www.mcmelectronics.com/product/28-17456 | Commutator: 6 channels
For 10 OpBoxes | Chamber Option: Home Cage Panel | Home Cage Panel | Altec | 21.2500 | 10 | $212.50 | Custom |  |  | http://deliriumlab.org/ | Home cage panel/insert
For 10 OpBoxes | Chamber Option: Rod floor | Chamber with rod floor | Dan-Kar | 350.0000 | 10 | $3500.00 | Custom |  |  | http://deliriumlab.org/ | Physiology chamber with rod floor
For 10 OpBoxes | Chamber Option: Tray floor | Chamber with tray floor | Dan-Kar | 300.0000 | 10 | $3000.00 | Custom |  |  | http://deliriumlab.org/ | Physiology chamber with tray floor
For 10 OpBoxes | Chamber Option: Food wall | Food Hopper w/Stainless steel bars |  |  |  |  | Custom
For 10 OpBoxes | Chamber Option: Food wall | Water bottle holder + Bottle w/bent spout |  |  |  |  | Custom
Possible 1 time expense | 3D Printer | 3M Hand Applicator Squeegee PA1-B Blue | Amazon | 5.1000 | 1 | $5.10 |  | PA1-B Blue | 3M | http://www.amazon.com/gp/product/B00657SFPE | Squeegee
Possible 1 time expense | 3D Printer | Flashforge Creator Pro 3D Printer | B & H PHOTO-VIDEO | 1349.0000 | 1 | $1349.00 | FL3DPRNTRCP | 3D-FFG-XPRO | FlashForge | http://www.bhphotovideo.com/c/product/1072996-REG/flashforge_3d_ffg_xpro_flashforge_3d_printer.html | Open source 3D printer
Possible 1 time expense | 3D Printer | 1.75mm Midnight Black PLA 3D Printing Filament 1kg (2.2lbs) Spool | M C M Electronics | 19.9900 | 4 | $79.96 | 310-0124 | 310-0124 | Stellar Labs Computer | http://www.mcmelectronics.com/product/310-0124#reviews | Black plastic filament for 1.75mm 3D printers (e.g. FlashForge Creator Pro, Makerbot Replicator)
Possible 1 time expense | 3D Printer | 1-1/2" Wide x 3-1/2" Long Flexible Blade Scraper with Ultra-Grip Handle | McMaster | 5.1300 | 1 | $5.13 | 35625A21 |  |  | http://www.mcmaster.com/#35625a21/=vtmflb | Putty knife
Possible 1 time expense | Behavior: Devices & PosTrack | IDC CRIMP TOOL | Newark | 19.5200 | 1 | $19.52 | 69C1030 | HT-214D | DURATOOL | http://www.newark.com/duratool/ht-214d/idc-crimp-tool/dp/69C1030?in_merch=Popular%20Connector%20Accessories | Crimping tool for ribbon connectors
Possible 1 time expense | Behavior: PosTrack | MTA 100: Insertion tool | Mouser | 30.1600 | 1 | $30.16 | 571-598031 | 59803-1 | TE Connectivity | http://www.mouser.com/ProductDetail/TE-Connectivity-AMP/59803-1/?qs=iXrEWqzBkTjikTm8fOqDbQ== | Insertion tool for MTA 100 connectors for ribbon cable assembly
Possible 1 time expense | Behavior: PosTrack & Extra Cables | CABLE 22AWG 6COND UNSHIELDED (100') | DigiKey | 90.7200 | 1 | $90.72 | A124-100-ND |  |  | http://www.digikey.com/product-detail/en/1176C%20SL005/A124-100-ND/204544 | Extra cables for wired connections
Possible 1 time expense | Computer | 4-Independent Port PCI Express USB 2.0 Adapter Card | Dell | 59.9900 | 1 | $59.99 | A3977189 | PEXUSB400 | StarTech.com | http://accessories.us.dell.com/sna/products/Cables/productdetail.aspx?c=us&l=en&s=bsd&cs=04&sku=A3977189 | For extra USB ports. Should be independent if want to use multiple webcams simultaneously
Possible 1 time expense | Computer | Desktop Computer | Dell | 699.9900 | 1 | $699.99 | XPS 8700 |  |  | http://www.dell.com/us/p/xps-8700/pd | Starts at 699.99, recommend Win7 64 bit, >=8GB RAM, >=1 TB hard disk
Possible 1 time expense | Solder | Soldering Stations > WES51 | DigiKey | 127.0000 | 1 | $127.00 | WES51-120V-ND |  |  | http://www.digikey.com/product-detail/en/WES51/WES51-120V-ND/526397 | Standard soldering station
Possible 1 time expense | Solder | Solder with Rosin Flux Core for Electronics 0.031" Diameter, 370°F Melting Temperature, 1 lb. without Silver | McMaster | 33.3700 | 1 | $33.37 | 7659A5 |  |  | http://www.mcmaster.com/#7659a5/=ugau56 | Standard solder for electronics
Software | Arduino | Arduino IDE |  | 0.0000 | 1 | $0.00 |  |  |  | http://arduino.cc/en/Main/Software | For programming arduinos
Software | Arduino & Webcam | Processing IDE |  | 0.0000 | 1 | $0.00 |  |  |  | https://processing.org/download/ | For running serial monitors
Software | Behavior & Physiology | OpBox Scripts |  | 0.0000 | 1 | $0.00 |  |  |  | http://deliriumlab.org/ | For Arduino Sketch, Processing Scripts, Maltab Scripts
Software | Open-source Software | Blender |  | 0.0000 | 1 | $0.00 |  |  |  | http://www.blender.org/download/ | For editing 3D models
Software | Open-source Software | Fritzing |  | 0.0000 | 1 | $0.00 |  |  |  | http://fritzing.org/download/ | For editing printed circuit board
Software | Physiology | Matlab & Data Acquisition Toolbox |  | 700.0000 | 1 | $700.00 |  |  |  | http://www.mathworks.com/ | Maltab Academic Pricing. Student & Personal pricing are lower if applicable. Recommend R2013a or more recent for continuous clocked digital & analog data acquisition

Sheet: CostReport
Sum of Total
Ordering frequency | SystemPart | Total
For 10 External Boxes | External Box | 743.4 | 74.34
For 10 External Boxes Total |  | 743.4 | 74.34
For 10 OpBoxes | Behavior: Arduino | 492.15 | 49.215
 | Behavior: Fluid | 320.32 | 32.032
 | Behavior: Nosepoke | 11.7 | 1.17
 | Behavior: Nosepoke & Operant Device Connections | 55.84 | 5.584
 | Behavior: Nosepoke: LED | 1.04 | 0.104
 | Behavior: Nosepoke: Spout | 16.08 | 1.608
 | Behavior: OpBoxShield | 513.78 | 51.378
 | Behavior: Operant Device Connections | 61.5 | 6.15
 | Behavior: PosTrack | 522.082 | 52.2082
 | Behavior: PosTrack + Pump | 3.6 | 0.36
 | Behavior: Speaker | 36.24 | 3.624
 | Behavior: Webcam | 110.9 | 11.09
 | Physiology: Acquisition from Amplifier | 2148.16 | 214.816
 | Physiology: Acquisition from Arduino | 84.53 | 8.453
 | Physiology: Amplifier 3Ch | 1123.09192 | 112.309192
 | Physiology: Amplifier 4Ch | 1381.94832 | 138.194832
 | Physiology: Battery Power | 30.064 | 3.0064
 | Physiology: Cable | 339.016 | 33.9016
 | Physiology: Commutator | 162.078 | 16.2078
 | Chamber Option: Home Cage Panel | 212.5 | 21.25
 | Chamber Option: Rod floor | 3500 | 350
 | Chamber Option: Tray floor | 3000 | 300
 | Chamber Option: Food wall |  | 0
For 10 OpBoxes Total |  | 14126.62024 | 1412.662024
Possible 1 time expense | 3D Printer | 1439.19
 | Behavior: Devices & PosTrack | 19.52
 | Behavior: PosTrack | 30.16
 | Behavior: PosTrack & Extra Cables | 90.72
 | Computer | 759.98
 | Solder | 160.37
Possible 1 time expense Total |  | 2499.94
Software | Arduino | 0
 | Arduino & Webcam | 0
 | Behavior & Physiology | 0
 | Open-source Software | 0
 | Physiology | 700
Software Total |  | 700
Grand Total |  | 18069.96024
