OpBox/OpBox_Master/HowTo/README

Step-by-step instructions for building and implementing different components of the OpBox system.

We have created parts lists on Octopart for components of our 3 and 4 channel amplifier PCBs:
3 Channel - https://octopart.com/bom-tool/aLpO8vOI
4 Channel - https://octopart.com/bom-tool/EUar2uGV
