OpBox/OpBox_Master/(commit log)

2019-03-15 Add Processing Code
    Processing sketch and formatted spreadsheets for subject/box info
    [BoxTable.csv, SubjectTable.csv]
2019-03-15 Add Arduino code
    Add Arduino sketch plus c header files and formatted spreadsheet showing connections/channel info
    [OpBoxShieldChannels.xls]
2019-03-15 Added supplemental information files
    [OpBoxPartsList.xls, OpBoxShieldChannels.xls]
2019-03-18 Cleaning up HowTo files
    [OpBoxPartsList.xls, OpBoxShieldChannels.xls]
2019-03-18 Renaming for clarity
    [BoxTable.csv, OpBoxShieldChannels.xls, SubjectTable.csv]
2020-07-10 Create PCBs
    Directory for gerber files used for PCB manufacturing
